akrasuski1/halb-cpu/images/prescaler.png

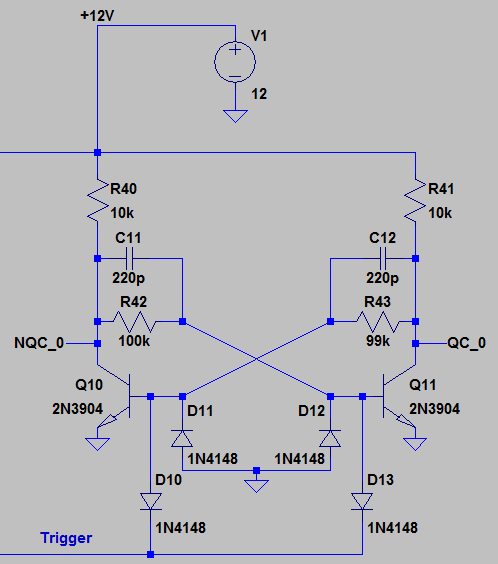
images/prescaler.png
