akrasuski1/halb-cpu/schematics/d_ff_6_nand.back.png

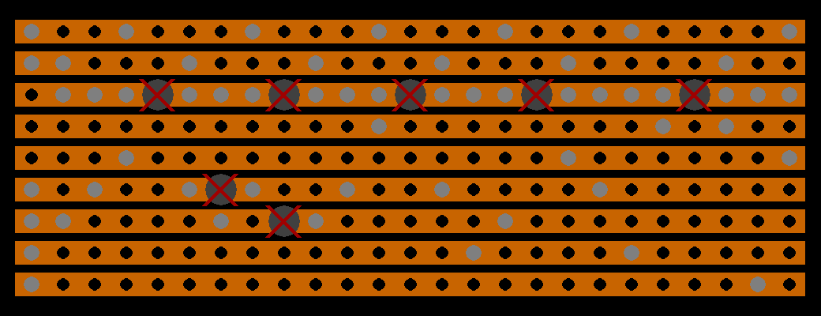
schematics/d_ff_6_nand.back.png
