akrasuski1/halb-cpu/schematics/d_ff_6_nand.png

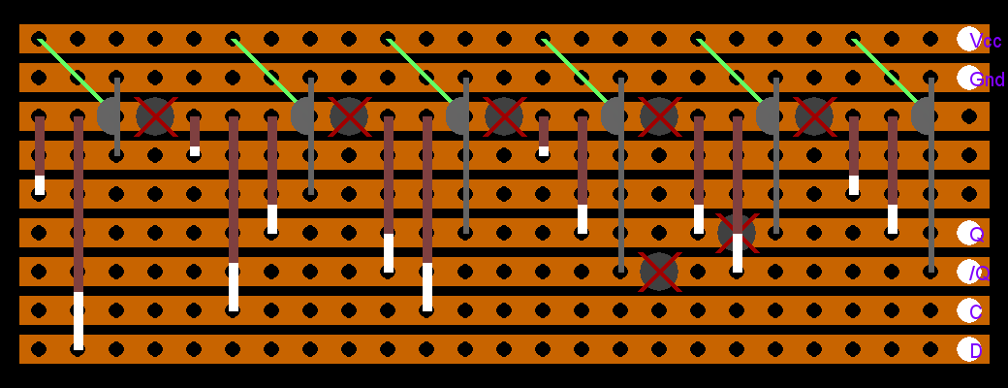
schematics/d_ff_6_nand.png
