akrasuski1/halb-cpu/schematics/d_ff_8_nand.back.png

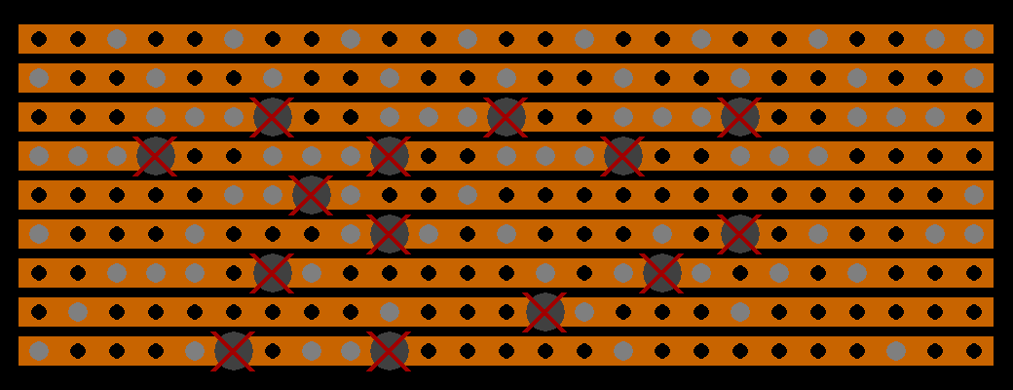
schematics/d_ff_8_nand.back.png
