akrasuski1/halb-cpu/schematics/d_ff_8_nand.png

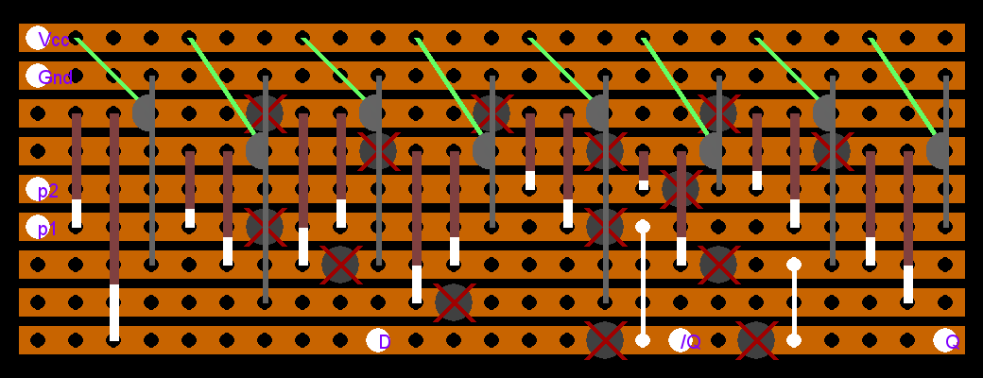
schematics/d_ff_8_nand.png
