akrasuski1/halb-cpu/schematics/dual_phase.back.png

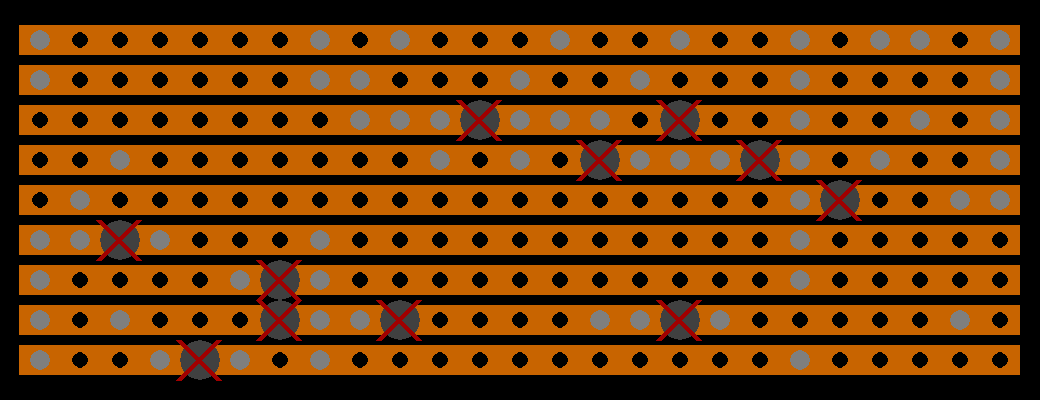
schematics/dual_phase.back.png
