akrasuski1/halb-cpu/schematics/dual_phase.png

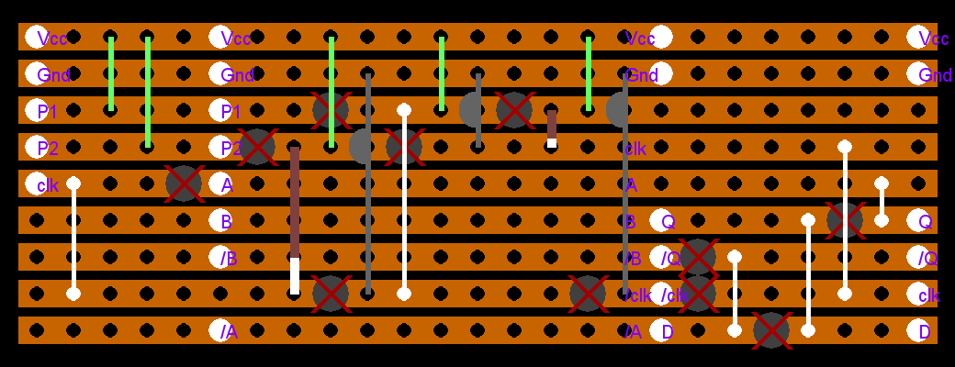
schematics/dual_phase.png
