akrasuski1/halb-cpu/schematics/dual_phase_helper.back.png

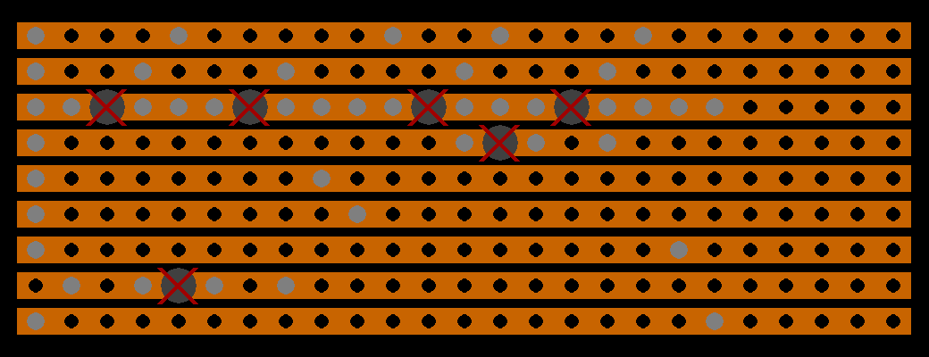
schematics/dual_phase_helper.back.png
