akrasuski1/halb-cpu/schematics/dual_phase_helper.png

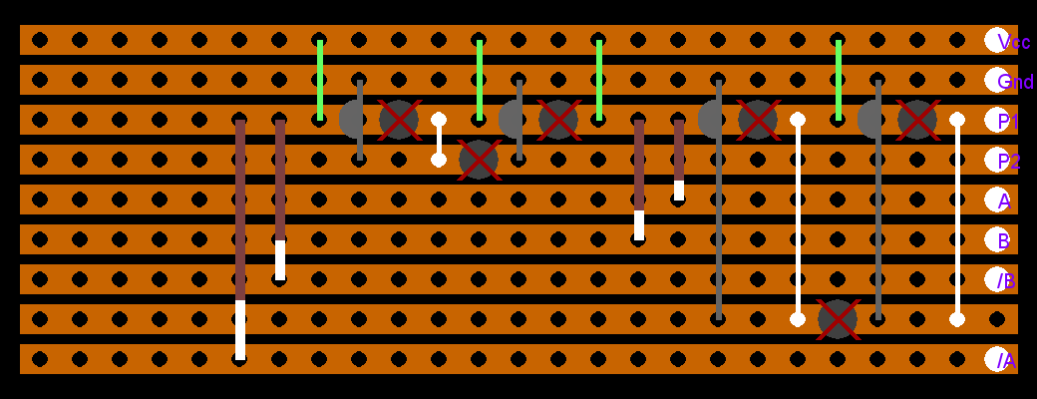
schematics/dual_phase_helper.png
