akrasuski1/halb-cpu/ltspice/dual_phase_bat.asc

C1: cap; 100p
C2: cap; 100p
Q1: npn; BC547B
Q2: npn; BC547B
Q3: npn; BC547B
Q4: npn; BC547B
Q5: npn; BC547B
Q6: npn; BC547B
Q7: npn; BC547B
Q8: npn; BC547B
Q9: npn; BC547B
Q10: npn; BC547B
Q11: npn; BC547B
Q13: npn; BC547B
Q14: npn; BC547B
Q15: npn; BC547B
Q16: npn; BC547B
Q17: npn; BC547B
Q18: npn; BC547B
Q19: npn; BC547B
Q20: npn; BC547B
Q21: npn; BC547B
Q24: npn; BC547B
Q25: npn; BC547B
R1: res; R=X
R2: res; R=Y
R3: res; R=X
R4: res; R=Y
R5: res; R=X
R6: res; R=X
R7: res; R=Y
R8: res; R=Y
R9: res; R=X
R10: res; R=Y
R11: res; R=X
R12: res; R=Y
R13: res; R=X
R14: res; R=Y
R15: res; R=X
R16: res; R=Y
R17: res; R=X
R18: res; R=Y
R19: res; R=X
R20: res; R=Y
R21: res; R=X
R22: res; R=Y
R25: res; R=X
R26: res; R=Y
R27: res; R=X
R28: res; R=Y
R29: res; R=X
R30: res; R=Y
R31: res; R=X
R32: res; R=Y
R33: res; R=X
R34: res; R=Y
R35: res; R=X
R36: res; R=Y
R37: res; R=X
R38: res; R=Y
R39: res; R=Pot
R40: res; R=Y
R41: res; R=X
R42: res; R=Y
R47: res; R=Pot2
R48: res; R=Y
R49: res; R=X
R50: res; R=Y
U1: BAT85
U2: BAT85
U3: BAT85
U4: BAT85
U5: BAT85
U6: BAT85
U7: BAT85
U8: BAT85
U9: BAT85
U10: BAT85
U11: BAT85
U12: BAT85
U13: BAT85
U14: BAT85
U15: BAT85
U16: BAT85
U17: BAT85
U18: BAT85
U19: BAT85
U20: BAT85
U22: BAT85
U23: BAT85
U24: BAT85
U25: BAT85
U26: BAT85
U27: BAT85
U28: BAT85
U29: BAT85
U30: BAT85
U31: BAT85
U32: BAT85
U33: BAT85
U34: BAT85
U35: BAT85
U36: BAT85
U37: BAT85
U38: BAT85
U40: BAT85
U41: BAT85
U42: BAT85
V1: voltage; 5
V2: voltage; PULSE(0 5 0 1e-9 1e-9 0.25u 0.5u)
Named nets: 0, COM, in, out, nout, out2, p1, p2, nout2, nin, write_1, write_2, gen_2, gen_1
.tran 0 2u 0 1e-9
.param X=2k Y=10k Pot=10*X Pot2=10*x
