akrasuski1/halb-cpu/ltspice/clock_div.asc

C1: cap; 47p
C2: cap; 47p
C3: cap; 47p
C4: cap; 47p
D1: diode; 1N4148
D2: diode; 1N4148
D3: diode; 1N4148
D4: diode; 1N4148
D5: diode; 1N4148
D6: diode; 1N4148
D7: diode; 1N4148
D8: diode; 1N4148
Q1: npn; BC547B
Q2: npn; BC547B
Q3: npn; BC547B
Q4: npn; BC547B
R1: res; 470
R2: res; 10k
R3: res; 470
R4: res; 10k
R5: res; 470
R6: res; 10k
R7: res; 470
R8: res; 10k
V1: voltage; 5
V2: voltage; PULSE(0 5 0 1e-9 1e-9 0.5e-7 1e-7)
Named nets: 0, COM, in, out, out2
.tran 0 2u 0 1e-9
