akrasuski1/halb-cpu/ltspice/clock_inv.asc

D1: diode; 1N4148
D2: diode; 1N4148
D3: diode; 1N4148
Q1: npn; BC547B
Q2: npn; BC547B
Q3: npn; BC547B
Q4: npn; BC547B
R1: res; 1k
R2: res; 470
R3: res; 4.7k
R4: res; 4.7k
R5: res; 270
V1: voltage; 5
V2: voltage; PULSE(0 5 0 1e-7 1e-7 1e-7 4e-7)
Named nets: 0, COM, in, out
.tran 0 1u 0 1e-9
