akrasuski1/halb-cpu/ltspice/dtl_cap.asc

C3: cap; {Z}
C4: cap; {Z}
C5: cap; {Z}
C6: cap; {Z}
C7: cap; {Z}
C8: cap; {Z}
C9: cap; {Z}
C10: cap; {Z}
C11: cap; {Z}
C12: cap; {Z}
C13: cap; {Z}
C14: cap; {Z}
C15: cap; {Z}
C16: cap; {Z}
C17: cap; {Z}
C18: cap; {Z}
C19: cap; {Z}
C20: cap; {Z}
C21: cap; {Z}
C22: cap; {Z}
C23: cap; {Z}
C24: cap; {Z}
C25: cap; {Z}
C26: cap; {Z}
C27: cap; {Z}
D5: diode; 1N4148
D6: diode; 1N4148
D7: diode; 1N4148
D8: diode; 1N4148
D9: diode; 1N4148
D10: diode; 1N4148
D11: diode; 1N4148
D12: diode; 1N4148
D13: diode; 1N4148
D14: diode; 1N4148
D15: diode; 1N4148
D16: diode; 1N4148
D17: diode; 1N4148
D18: diode; 1N4148
D19: diode; 1N4148
D20: diode; 1N4148
D21: diode; 1N4148
D22: diode; 1N4148
D23: diode; 1N4148
D24: diode; 1N4148
D25: diode; 1N4148
D26: diode; 1N4148
D27: diode; 1N4148
D28: diode; 1N4148
D29: diode; 1N4148
D30: diode; 1N4148
D31: diode; 1N4148
D32: diode; 1N4148
D33: diode; 1N4148
D34: diode; 1N4148
D35: diode; 1N4148
D36: diode; 1N4148
D37: diode; 1N4148
D38: diode; 1N4148
D39: diode; 1N4148
D40: diode; 1N4148
D41: diode; 1N4148
D42: diode; 1N4148
D43: diode; 1N4148
D44: diode; 1N4148
D45: diode; 1N4148
D46: diode; 1N4148
D47: diode; 1N4148
D48: diode; 1N4148
D49: diode; 1N4148
D50: diode; 1N4148
D51: diode; 1N4148
D52: diode; 1N4148
D53: diode; 1N4148
D54: diode; 1N4148
Q2: npn; BC547B
Q3: npn; BC547B
Q4: npn; BC547B
Q5: npn; BC547B
Q6: npn; BC547B
Q7: npn; BC547B
Q8: npn; BC547B
Q9: npn; BC547B
Q10: npn; BC547B
Q11: npn; BC547B
Q12: npn; BC547B
Q13: npn; BC547B
Q14: npn; BC547B
Q15: npn; BC547B
Q16: npn; BC547B
Q17: npn; BC547B
Q18: npn; BC547B
Q19: npn; BC547B
Q20: npn; BC547B
Q21: npn; BC547B
Q22: npn; BC547B
Q23: npn; BC547B
Q24: npn; BC547B
Q25: npn; BC547B
Q26: npn; BC547B
R1: res; R=X
R5: res; R=Y
R6: res; R=X
R7: res; R=Y
R8: res; R=X
R9: res; R=Y
R10: res; R=X
R11: res; R=Y
R12: res; R=X
R13: res; R=Y
R14: res; R=X
R15: res; R=Y
R16: res; R=X
R17: res; R=Y
R18: res; R=X
R19: res; R=Y
R20: res; R=X
R21: res; R=Y
R22: res; R=X
R23: res; R=Y
R24: res; R=X
R25: res; R=Y
R26: res; R=X
R27: res; R=Y
R28: res; R=X
R29: res; R=Y
R30: res; R=X
R31: res; R=Y
R32: res; R=X
R33: res; R=Y
R34: res; R=X
R35: res; R=Y
R36: res; R=X
R37: res; R=Y
R38: res; R=X
R39: res; R=Y
R40: res; R=X
R41: res; R=Y
R42: res; R=X
R43: res; R=Y
R44: res; R=X
R45: res; R=Y
R46: res; R=X
R47: res; R=Y
R48: res; R=X
R49: res; R=Y
R50: res; R=X
R51: res; R=Y
R52: res; R=X
R53: res; R=Y
V1: voltage; 5
V2: voltage; PULSE(0 5 0 1e-9 1e-9 1u 2u)
Named nets: 0, COM, in, out1, out2, out3, out_single
.tran 0 2.5u 0.9u 1e-9
.param X=47k Y=47k Z=47p
