akrasuski1/halb-cpu/ltspice/dtl_schottky.asc

D1: schottky; 1N5818
D2: schottky; 1N5818
D3: schottky; 1N5818
D4: schottky; 1N5818
D5: schottky; 1N5818
D6: schottky; 1N5818
D7: schottky; 1N5818
D8: schottky; 1N5818
D9: schottky; 1N5818
D10: schottky; 1N5818
D11: schottky; 1N5818
D12: schottky; 1N5818
D13: schottky; 1N5818
D14: schottky; 1N5818
D15: schottky; 1N5818
D16: schottky; 1N5818
D17: schottky; 1N5818
D18: schottky; 1N5818
D19: schottky; 1N5818
D20: schottky; 1N5818
D21: schottky; 1N5818
D22: schottky; 1N5818
D23: schottky; 1N5818
D24: schottky; 1N5818
D25: schottky; 1N5818
D26: schottky; 1N5818
D27: schottky; 1N5818
D28: schottky; 1N5818
D29: schottky; 1N5818
D30: schottky; 1N5818
D31: schottky; 1N5818
D32: schottky; 1N5818
D33: schottky; 1N5818
D34: schottky; 1N5818
D35: schottky; 1N5818
D36: schottky; 1N5818
Q1: npn; BC547B
Q2: npn; BC547B
Q3: npn; BC547B
Q4: npn; BC547B
Q5: npn; BC547B
Q6: npn; BC547B
Q7: npn; BC547B
Q8: npn; BC547B
Q9: npn; BC547B
Q10: npn; BC547B
Q11: npn; BC547B
Q12: npn; BC547B
Q13: npn; BC547B
Q14: npn; BC547B
Q15: npn; BC547B
Q16: npn; BC547B
Q17: npn; BC547B
Q18: npn; BC547B
Q19: npn; BC547B
Q20: npn; BC547B
Q21: npn; BC547B
Q22: npn; BC547B
Q23: npn; BC547B
Q24: npn; BC547B
Q25: npn; BC547B
Q26: npn; BC547B
Q27: npn; BC547B
Q28: npn; BC547B
Q29: npn; BC547B
Q30: npn; BC547B
Q31: npn; BC547B
Q32: npn; BC547B
Q33: npn; BC547B
Q34: npn; BC547B
Q35: npn; BC547B
Q36: npn; BC547B
R1: res; R=X
R2: res; R=Y
R3: res; R=X
R4: res; R=Y
R5: res; R=X
R6: res; R=X
R7: res; R=Y
R8: res; R=Y
R9: res; R=X
R10: res; R=Y
R11: res; R=X
R12: res; R=Y
R13: res; R=X
R14: res; R=Y
R15: res; R=X
R16: res; R=Y
R17: res; R=X
R18: res; R=Y
R19: res; R=X
R20: res; R=Y
R21: res; R=X
R22: res; R=Y
R23: res; R=X
R24: res; R=Y
R25: res; R=X
R26: res; R=Y
R27: res; R=X
R28: res; R=Y
R29: res; R=X
R30: res; R=Y
R31: res; R=X
R32: res; R=Y
R33: res; R=X
R34: res; R=Y
R35: res; R=X
R36: res; R=Y
R37: res; R=X
R38: res; R=Y
R39: res; R=X
R40: res; R=Y
R41: res; R=X
R42: res; R=Y
R43: res; R=X
R44: res; R=Y
R45: res; R=X
R46: res; R=Y
R47: res; R=X
R48: res; R=Y
R49: res; R=X
R50: res; R=Y
R51: res; R=X
R52: res; R=Y
R53: res; R=X
R54: res; R=Y
R55: res; R=X
R56: res; R=Y
R57: res; R=X
R58: res; R=Y
R59: res; R=X
R60: res; R=Y
R61: res; R=X
R62: res; R=Y
R63: res; R=X
R64: res; R=Y
R65: res; R=X
R66: res; R=Y
R67: res; R=X
R68: res; R=Y
R69: res; R=X
R70: res; R=Y
R71: res; R=X
R72: res; R=Y
V1: voltage; 5
V2: voltage; PULSE(0 5 0 1e-9 1e-9 1u 2u)
V3: voltage; PULSE(0 5 0 100u 100u 100u 400u)
Named nets: 0, COM, in, out_single, out1, out2, out3, out_multi, out_multi2, out_single_x, out_single_y
.tran 0 2u 1u 1e-8
.param X=4.7k Y=4.7k
