akrasuski1/halb-cpu/ltspice/dtl4.asc

D1: diode; 1N4148
D2: diode; 1N4148
D3: diode; 1N4148
Q1: npn; BC547B
R1: res; R=X
R2: res; R=Y
V1: voltage; 5
V2: voltage; PULSE(0 5 0 1e-9 1e-9 3u 6u)
Named nets: 0, COM, in, out
.tran 0 10u 0 1n
.param X=47k Y=47k
