akrasuski1/halb-cpu/ltspice/ttl1.asc

Q1: npn; BC547B
Q2: npn; BC547B
R1: res; 47k
R2: res; 47k
V1: voltage; 5
V2: voltage; PULSE(0 5 0 1e-9 1e-9 1.5u 3u)
Named nets: 0, COM, in, out
.tran 0 10u 0 0.001u
