akrasuski1/halb-cpu/ltspice/ttl2.asc

Q1: npn; BC547B
Q2: npn; BC547B
Q3: npn; BC547B
Q4: npn; BC547B
Q5: npn; BC547B
Q6: npn; BC547B
R1: res; 47k
R2: res; 47k
R3: res; 47k
R4: res; 47k
R5: res; 47k
R6: res; 47k
V1: voltage; 5
V2: voltage; PULSE(0 5 0 1e-9 1e-9 1.5u 3u)
Named nets: 0, COM, in, out1, out2, out3
.tran 0 10u 0 0.001u
