akrasuski1/halb-cpu/ltspice/dtl1.asc

D1: diode; 1N4148
Q1: npn; BC547B
R1: res; 47k
R2: res; 47k
V1: voltage; 5
V2: voltage; PULSE(0 5 0 1e-9 1e-9 100u 200u)
Named nets: 0, COM, out, in
.tran 0 350u 50u 0.1u
