akrasuski1/halb-cpu/(list of files, drawings)

Other design files:
schematics/alu.circ
schematics/d_ff_6_nand.circ
schematics/d_ff_8_nand.circ
schematics/dual_phase.circ
