akrasuski1/halb-cpu/(commit log)

2018-10-02 Switch jump destinations
2018-10-02 Switch jump
2018-10-28 Add 6 nand D flip flop stripboard schematic
    [alu.circ, d_ff_6_nand.circ]
2018-10-31 Add more schematics
    [d_ff_8_nand.circ, dual_phase.circ]
